Llamero/RPi_IO_Hat_v1/Parts List (Bill of Materials).ods

Pi Hat Assembly:
Digikey
x | Part | Part # | Mount | Quantity | Link
J1 | TERM BLOCK 11POS TOP ENTRY 3.5MM | 277-12233-ND | Clip | 1 | https://www.digikey.com/products/en?keywords=277-12233-ND
J3 | CONN RCPT 40POS 0.1 GOLD PCB | SAM11959-ND | TH | 1 | https://www.digikey.com/products/en?keywords=SAM11959-ND
Q0-Q9 | MOSFET N-CH 250V 240MA SOT-89 | ZVN4525ZCT-ND | SMD | 10 | https://www.digikey.com/products/en?keywords=ZVN4525ZCT-ND
RN1 | RES ARRAY 10 RES 1K OHM 20SOIC | 4820P-1-102LFCT-ND | SMD | 1 | https://www.digikey.com/products/en?keywords=4820P-1-102LFCT-ND
Optional cooling for over-clocking:
J2 | FAN AXIAL 20X8MM VAPO 5VDC WIRE | 259-1561-ND | Glue | 1 | https://www.digikey.com/products/en?keywords=259-1561-ND
J4 | HEATSINK 19X19X23MM PIN | 345-1149-ND | Glue | 1 | https://www.digikey.com/products/en?keywords=345-1149-ND
J5 | HEATSINK CPU XCUT | AE11388-ND | Glue | 1 | https://www.digikey.com/products/en?keywords=AE11388-ND
Raspberry Pi 3b+ kit:
Amazon
Raspberry Pi 3b+ kit | CanaKit Raspberry Pi 3 B+ (B Plus) Starter Kit (32 GB EVO+ Edition, Case) | B07BCC8PK7 |  | 1 | https://www.amazon.com/CanaKit-Raspberry-Starter-Premium-Black/dp/B07BCC8PK7/
Miscellaneous (tools, consumables, etc.):
Digikey
Solder paste for reflow soldering | SLDR PASTE NO-CLN SN63/PB37 50G | SMD291AX50T3-ND |  | 1 | https://www.digikey.com/products/en?keywords=SMD291AX50T3-ND
Solder wire for header through hole soldering | SOLDER WIRE POCKET PACK 60/40 TI | SMD2SW.031.7OZ-ND |  | 1 | https://www.digikey.com/products/en?keywords=SMD2SW.031.7OZ-ND
Thermal adhesive for mounting heatsinks | ADHESIVE - THERMAL CONDUCTIVE EP | 473-1220-ND |  | 1 | https://www.digikey.com/products/en?keywords=473-1220-ND
Soldering iron for through hole soldering | SOLDERING IRON 50W 120V | 1528-1684-ND |  | 1 | https://www.digikey.com/products/en?keywords=1528-1684-ND
IR thermometer for tracking reflow temperatures | Backlit LCD Infrared Thermometer, Laser Sighting: Single Dot, -30° to 500° | 614-1481-ND |  | 1 | https://www.digikey.com/products/en?keywords=614-1481-ND
OnlineMetals.com
Copper block as a hot plate heat spreader | 6" x 6" x 1/4" copper block | 1920 |  | 1 | https://www.onlinemetals.com/merchant.cfm?pid=1920&step=4&showunits=inches&id=1118&top_cat=87
