Llamero/RPi_IO_Hat_v1/CAD files/RPi IO board only.stp

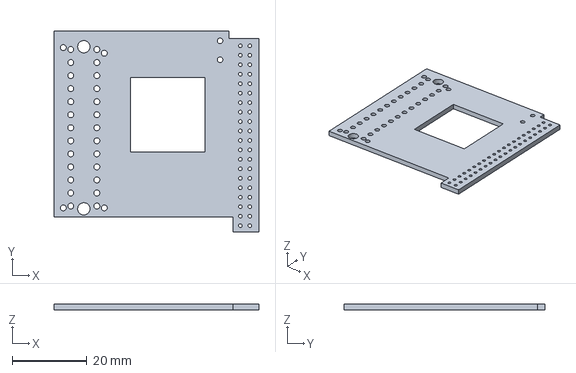
[picture p1: CAD file, 2019-02-22]
CAD files/RPi IO board only.stp
55.0 x 54.0 x 1.60 mm
