Llamero/RPi_IO_Hat_v1/KiCAD design files/Behavior rig board.pdf

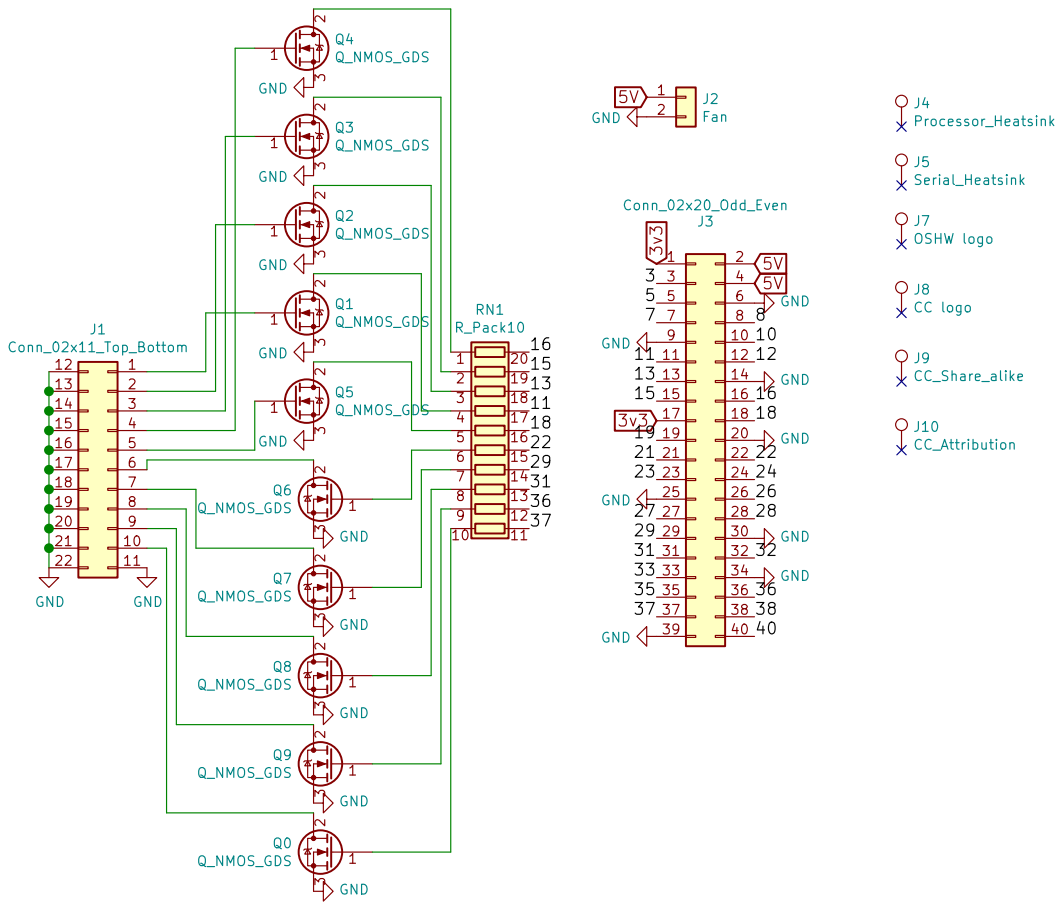
[picture p2: page 1]
