Llamero/RPi_IO_Hat_v1/KiCAD design files/Behavior rig board.kicad_pcb

## KiCad design KiCAD design files/Behavior rig board.kicad_pcb (2019-02-22)

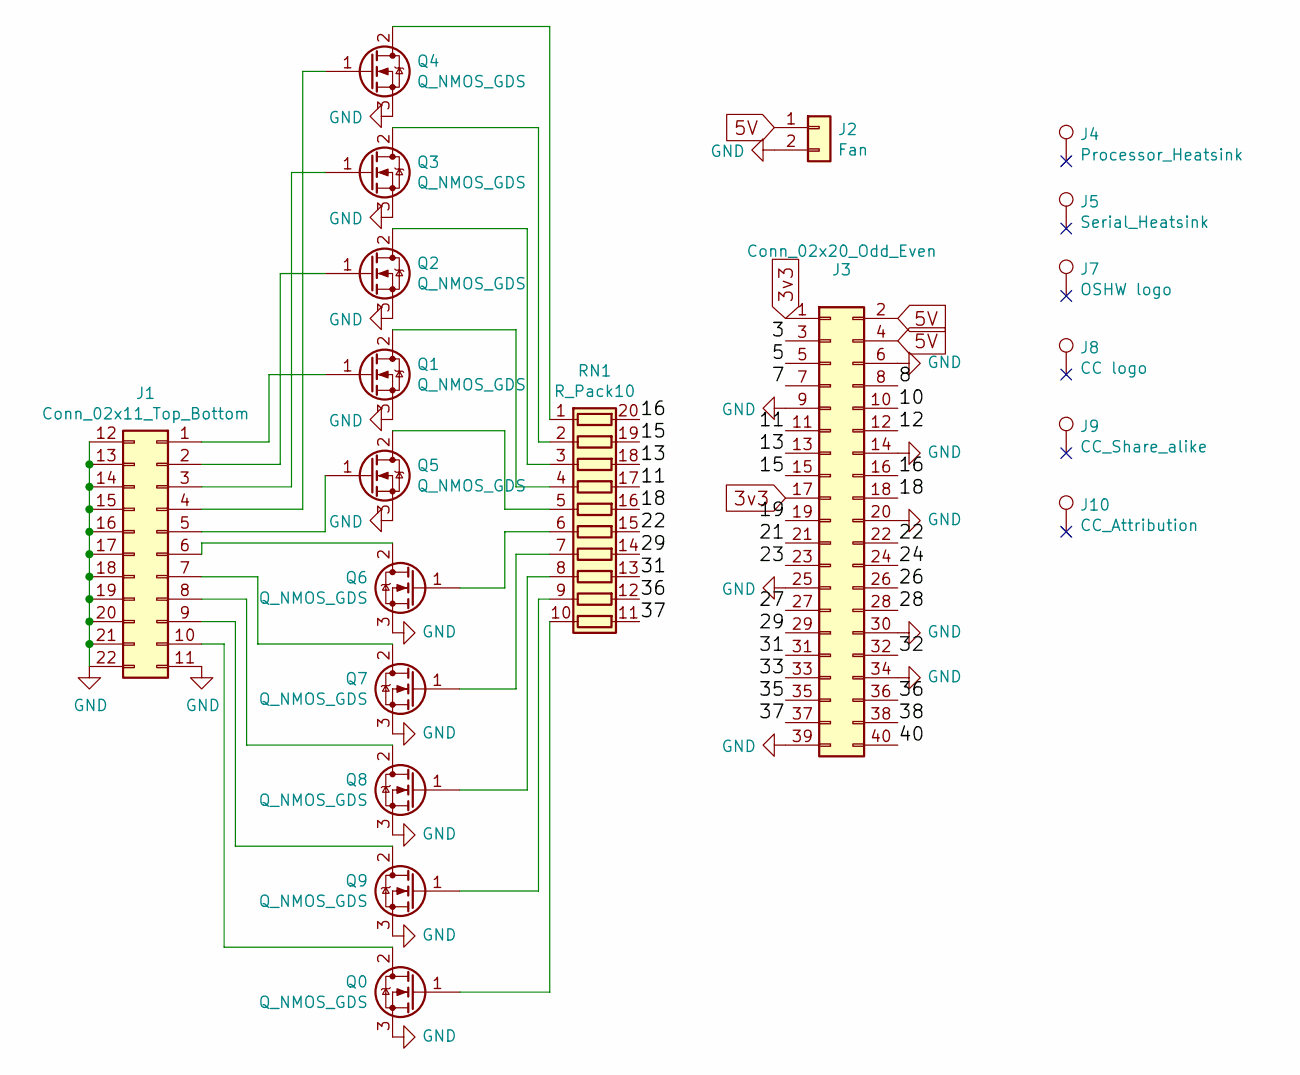
[picture p3: schematic Behavior rig board.sch]

Parts:
J1: Conn_02x11_Top_Bottom; PHOENIX_1848736-11x2_terminal_block; Digikey Part # 277-12233-ND
J2: Fan; SolderWirePad_2x_1-5mmDrill; Digikey Part # 259-1561-ND
J3: Conn_02x20_Odd_Even; Pi_Stackable_Socket_Straight_2x20_Pitch2.54mm; Digikey Part # SAM11959-ND
J4: Processor_Heatsink; WV_19x19mm_heatsink; Digikey Part # 345-1149-ND
J5: Serial_Heatsink; Digikey Part # AE11388-ND
J7: OSHW logo; OSHW-Symbol_6.7x6mm_SilkScreen
J8: CC logo; CC_silkscreen
J9: CC_Share_alike
J10: CC_Attribution
Q0, Q1, Q2, Q3, Q4, Q5, Q6, Q7, Q8, Q9: Q_NMOS_GDS; SOT-89-3; Digikey Part # ZVN4525ZCT-ND
RN1: R_Pack10; Bourns_4820P-1-102LF; Digikey Part # 4820P-1-102LFCT-ND

Connections:
3v3: J3.1, J3.17
5V: J2.1, J3.2, J3.4
/3: J3.3
/5: J3.5
/7: J3.7
/8: J3.8
/10: J3.10
/11: J3.11, RN1.17 (R4.2)
/12: J3.12
/13: J3.13, RN1.18 (R3.2)
/15: J3.15, RN1.19 (R2.2)
/16: J3.16, RN1.20 (R1.2)
/18: J3.18, RN1.16 (R5.2)
/19: J3.19
/21: J3.21
/22: J3.22, RN1.15 (R6.2)
/23: J3.23
/24: J3.24
/26: J3.26
/27: J3.27
/28: J3.28
/29: J3.29, RN1.14 (R7.2)
/31: J3.31, RN1.13 (R8.2)
/32: J3.32
/33: J3.33
/35: J3.35
/36: J3.36, RN1.12 (R9.2)
/37: J3.37, RN1.11 (R10.2)
/38: J3.38
/40: J3.40
GND: J1.11, J1.12, J1.13, J1.14, J1.15, J1.16, J1.17, J1.18, J1.19, J1.20, J1.21, J1.22, J2.2, J3.6, J3.9, J3.14, J3.20, J3.25, J3.30, J3.34, J3.39, Q0.3 (S), Q1.3 (S), Q2.3 (S), Q3.3 (S), Q4.3 (S), Q5.3 (S), Q6.3 (S), Q7.3 (S), Q8.3 (S), Q9.3 (S)
unnamed: J1.1, Q1.1 (G)
unnamed: J1.2, Q2.1 (G)
unnamed: J1.3, Q3.1 (G)
unnamed: J1.4, Q4.1 (G)
unnamed: J1.5, Q5.1 (G)
unnamed: J1.6, Q6.2 (D)
unnamed: J1.7, Q7.2 (D)
unnamed: J1.8, Q8.2 (D)
unnamed: J1.9, Q9.2 (D)
unnamed: J1.10, Q0.2 (D)
unnamed: Q0.1 (G), RN1.10 (R10.1)
unnamed: Q1.2 (D), RN1.4 (R4.1)
unnamed: Q2.2 (D), RN1.3 (R3.1)
unnamed: Q3.2 (D), RN1.2 (R2.1)
unnamed: Q4.2 (D), RN1.1 (R1.1)
unnamed: Q5.2 (D), RN1.5 (R5.1)
unnamed: Q6.1 (G), RN1.6 (R6.1)
unnamed: Q7.1 (G), RN1.7 (R7.1)
unnamed: Q8.1 (G), RN1.8 (R8.1)
unnamed: Q9.1 (G), RN1.9 (R9.1)

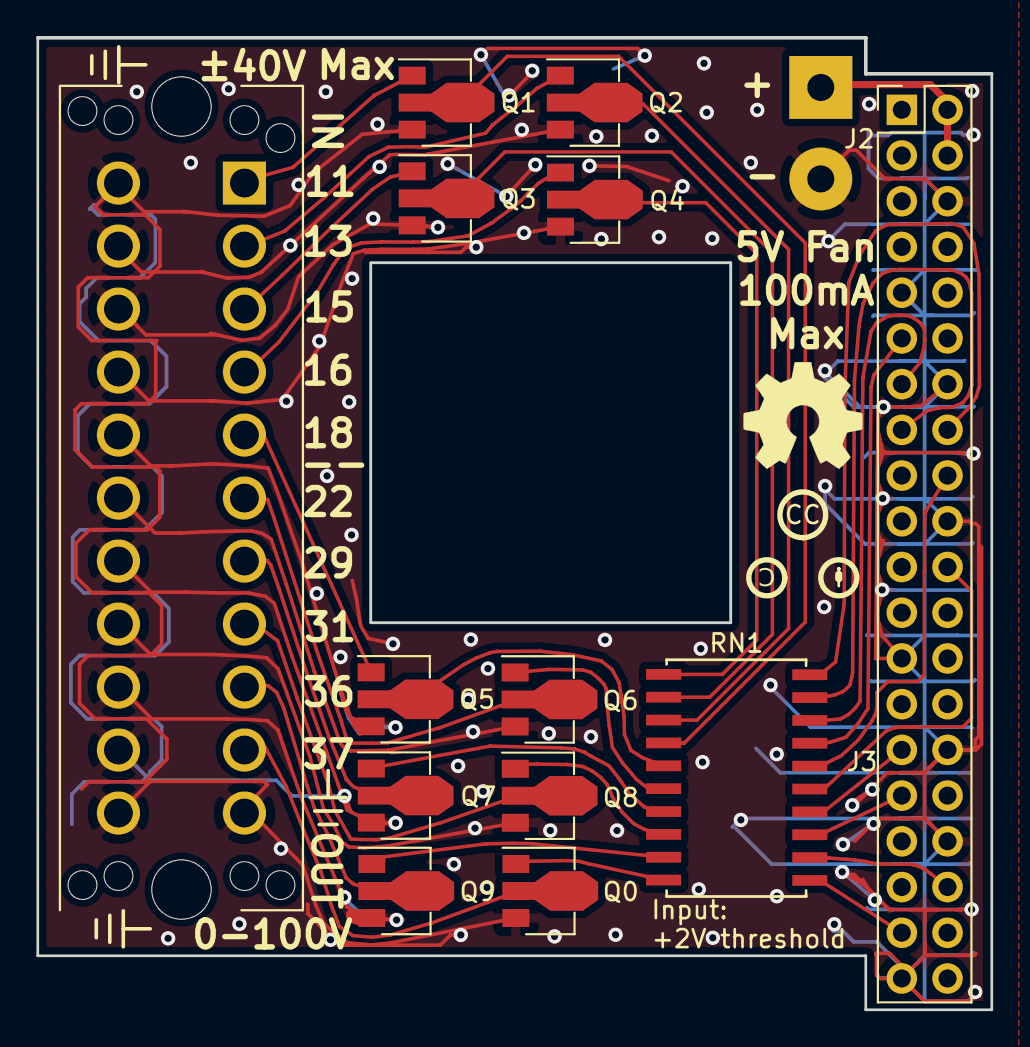
[picture p4: board Behavior rig board.kicad_pcb from above]

Board: 2 copper layers, 53.0 x 54.0 mm, 19 parts (0 on the bottom side), 33 nets.
