Llamero/RPi_IO_Hat_v1/(commit log)

2019-02-22 Upload KiCAD files
    [Behavior rig board - backup1.kicad_pcb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]
2019-02-23 Add gerber and CAD files
    [Behavior rig board-B.Cu.gbl, Behavior rig board-B.Mask.gbs, Behavior rig board-B.Paste.gbp, Behavior rig board-B.SilkS.gbo, Behavior rig board-Edge.Cuts.gm1, Behavior rig board-F.Cu.gtl, Behavior rig board-F.Mask.gts, Behavior rig board-F.Paste.gtp]
2019-02-23 BOM added
    [Parts List (Bill of Materials).ods]
2019-02-23 Manual and BOM added
    [Parts List (Bill of Materials).ods]
